TGit-Tech/Tode-IO/README.md

-----------------------------------------------------------------------------------
# Tode-IO (Part of the Tode-RC Project)
-----------------------------------------------------------------------------------
Various Input/Output (IO) accessibility hardware for a Tode-RC.

Visit https://github.com/TGit-Tech/Tode-RC

-----------------------------------------------------------------------------------
# Models
-----------------------------------------------------------------------------------
- Tode-ACCESSORY
	- Mounting Plates for 8.7x6.7x4.3 Project Boxes
	- Pole Mount Antenna Bracket

- Tode-BIOPH (Back-IO Pin Header)\
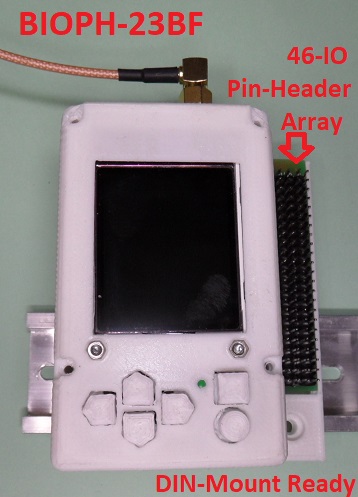
[picture p1: pics/BIOPH-23BF.jpg]


- Tode-IOSTB (IO Screw Terminal Block)\
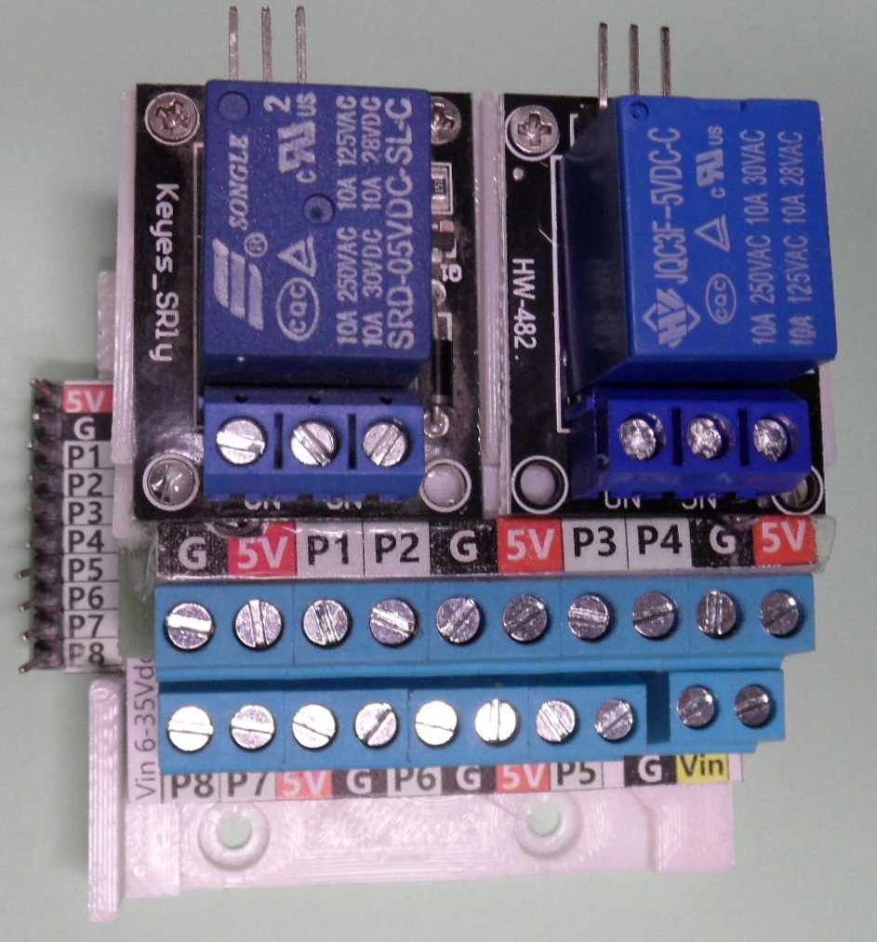
[picture p2: pics/IOSTB.24B7.jpg]


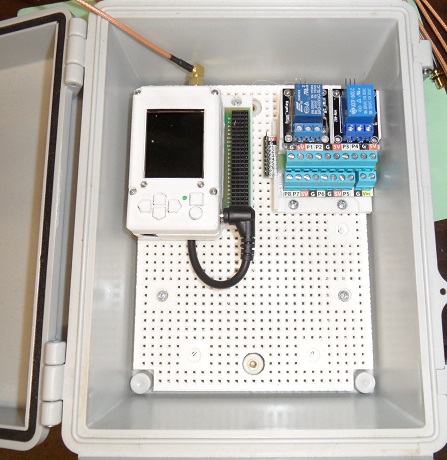
[picture p3: pics/BIOPHandIOSTB.jpg]
