TGit-Tech/Tode-IO/Tode-IOSTB/docs/Tode-IOSTB.24B7 Stickers.pdf

G | 5V | P1 | P2 | G | 5V | P3 | P4 | G | 5V
G | 5V | P1 | P2 | G | 5V | P3 | P4 | G | 5V
G | 5V | P1 | P2 | G | 5V | P3 | P4 | G | 5V
G | 5V | P1 | P2 | G | 5V | P3 | P4 | G | 5V
G | 5V | P1 | P2 | G | 5V | P3 | P4 | G | 5V
G | 5V | P1 | P2 | G | 5V | P3 | P4 | G | 5V
G | 5V | P1 | P2 | G | 5V | P3 | P4 | G | 5V
G | 5V | P1 | P2 | G | 5V | P3 | P4 | G | 5V
G | 5V | P1 | P2 | G | 5V | P3 | P4 | G | 5V
G | 5V | P1 | P2 | G | 5V | P3 | P4 | G | 5V
G | 5V | P1 | P2 | G | 5V | P3 | P4 | G | 5V
G | 5V | P1 | P2 | G | 5V | P3 | P4 | G | 5V
G | 5V | P1 | P2 | G | 5V | P3 | P4 | G | 5V
G | 5V | P1 | P2 | G | 5V | P3 | P4 | G | 5V
G | 5V | P1 | P2 | G | 5V | P3 | P4 | G | 5V
G | 5V | P1 | P2 | G | 5V | P3 | P4 | G | 5V
G | 5V | P1 | P2 | G | 5V | P3 | P4 | G | 5V
G | 5V | P1 | P2 | G | 5V | P3 | P4 | G | 5V
G | 5V | P1 | P2 | G | 5V | P3 | P4 | G | 5V
G | 5V | P1 | P2 | G | 5V | P3 | P4 | G | 5V
P8 P7 5V | G | P6 | G | 5V P5 | G VIN

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
P8 P7 5V | G | P6 | G | 5V P5 | G | Vin

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
Vin 6-35Vdc

P8 P7 5V | G | P6 | G | 5V P5 | G VIN

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
P8 P7 5V | G | P6 | G | 5V P5 | G | Vin

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
Vin 6-35Vdc

P8 P7 5V | G | P6 | G | 5V P5 | G VIN

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
P8 P7 5V | G | P6 | G | 5V P5 | G | Vin

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
Vin 6-35Vdc

P8 P7 5V | G | P6 | G | 5V P5 | G VIN

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
P8 P7 5V | G | P6 | G | 5V P5 | G | Vin

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
Vin 6-35Vdc

P8 P7 5V | G | P6 | G | 5V P5 | G VIN

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
P8 P7 5V | G | P6 | G | 5V P5 | G | Vin

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
Vin 6-35Vdc

P8 P7 5V | G | P6 | G | 5V P5 | G VIN

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
P8 P7 5V | G | P6 | G | 5V P5 | G | Vin

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
Vin 6-35Vdc

P8 P7 5V | G | P6 | G | 5V P5 | G VIN

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
P8 P7 5V | G | P6 | G | 5V P5 | G | Vin

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
Vin 6-35Vdc

P8 P7 5V | G | P6 | G | 5V P5 | G VIN

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
P8 P7 5V | G | P6 | G | 5V P5 | G | Vin

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
Vin 6-35Vdc
