TGit-Tech/Tode-IO/pics/IOSTB-Bottom+TopPCB-Layout.jpg

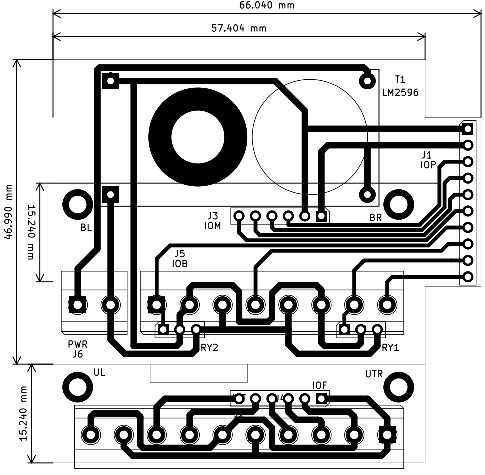
pics/IOSTB-Bottom+TopPCB-Layout.jpg
