TGit-Tech/Tode-IO/pics/IOSTB-BottomPCB-Schematic.jpg

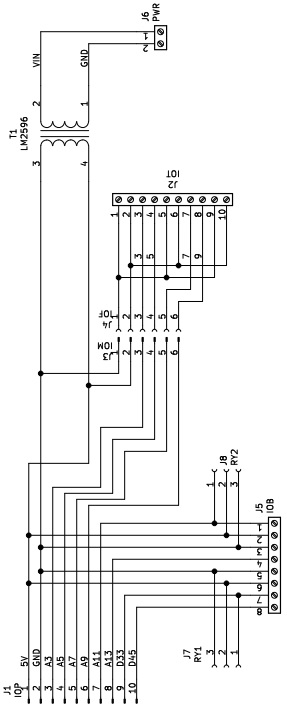
pics/IOSTB-BottomPCB-Schematic.jpg
