TGit-Tech/Tode-IO/pics/Joinfworld 6x6x4 Commercial Box.jpg

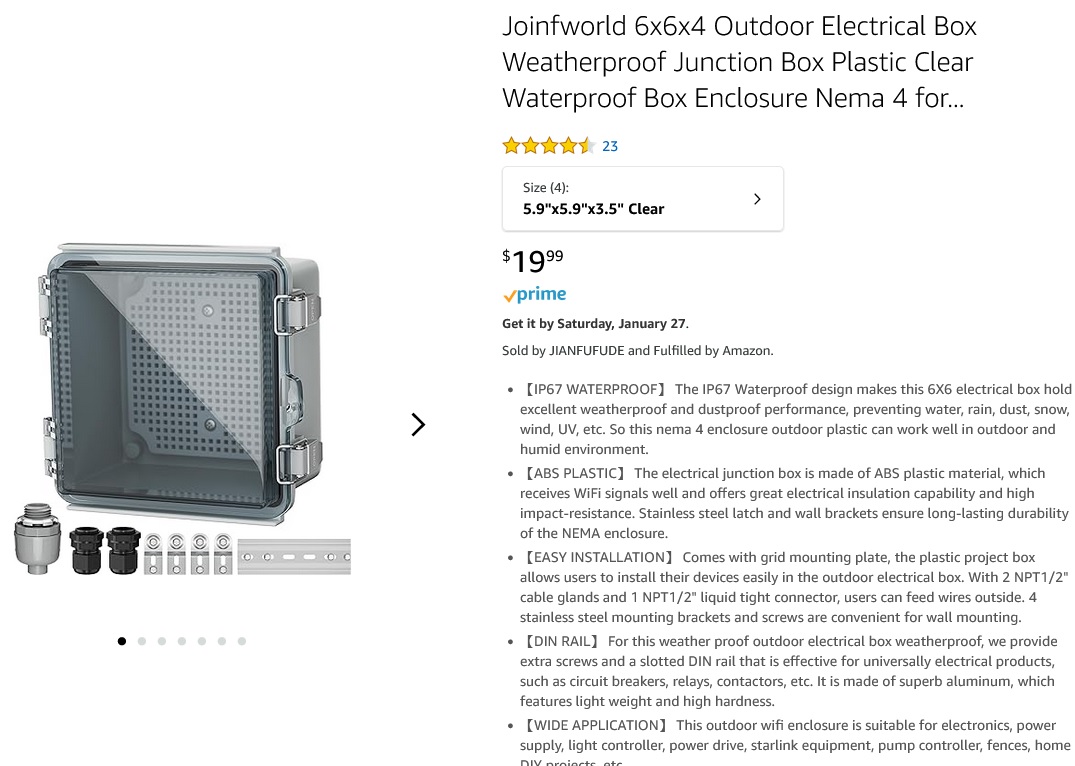
pics/Joinfworld 6x6x4 Commercial Box.jpg
