TGit-Tech/Tode-IO/Tode-ACCESSORY/pics/PoleMountAntennaBracket.png

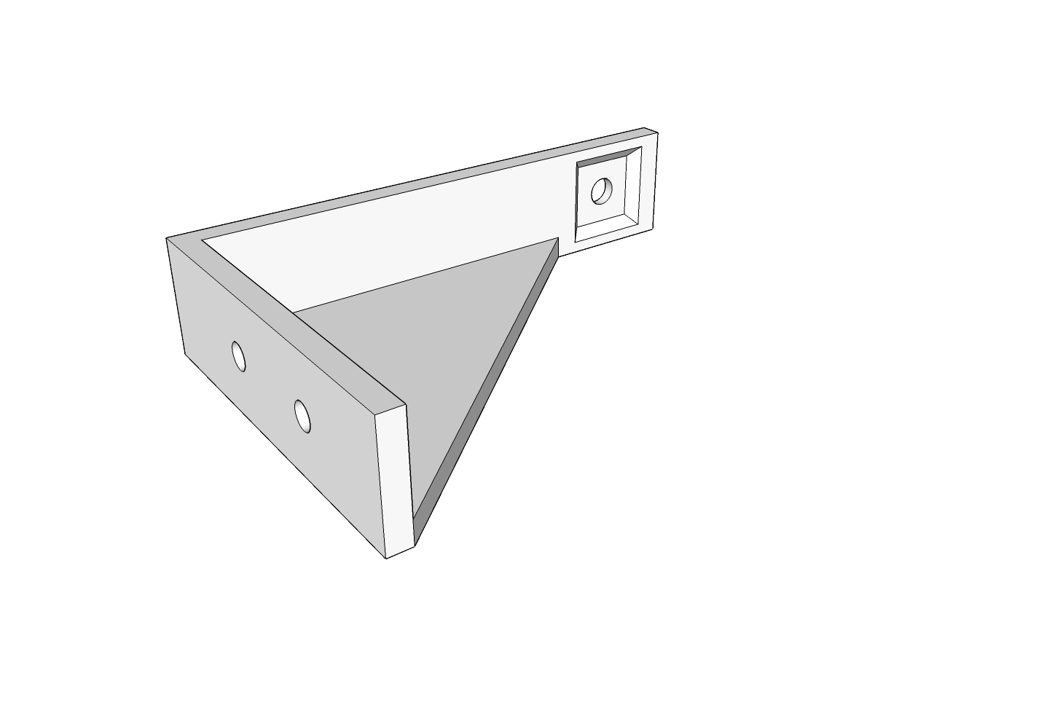
Tode-ACCESSORY/pics/PoleMountAntennaBracket.png
