TGit-Tech/Tode-IO/Tode-ACCESSORY/pics/SAM_7703.JPG

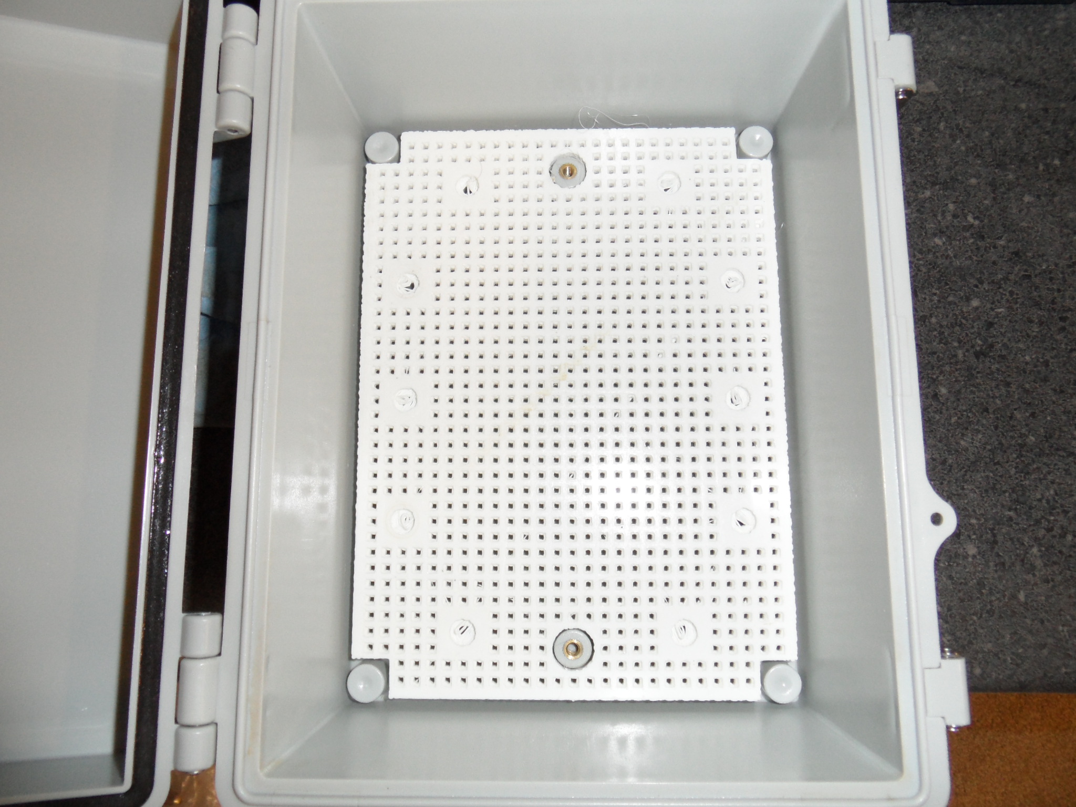
Tode-ACCESSORY/pics/SAM_7703.JPG
