TGit-Tech/Tode-IO/Tode-ACCESSORY/pics/SIOST-Zulkit974-6ScrewGrid.png

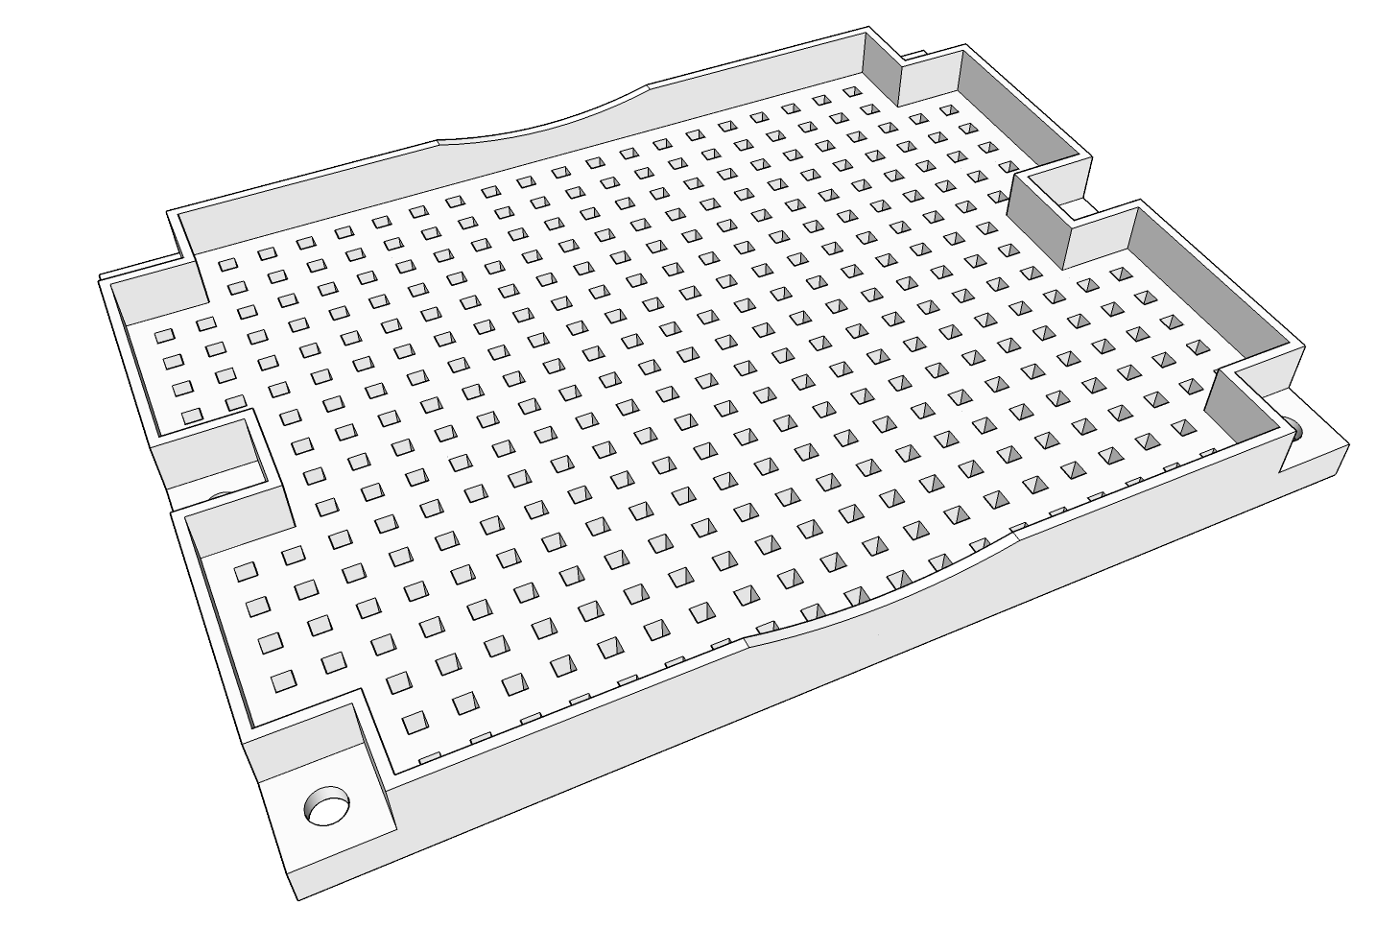
Tode-ACCESSORY/pics/SIOST-Zulkit974-6ScrewGrid.png
