TGit-Tech/Tode-IO/Tode-BIOPH/kicad/IO-ACCESS/Schematic.jpg

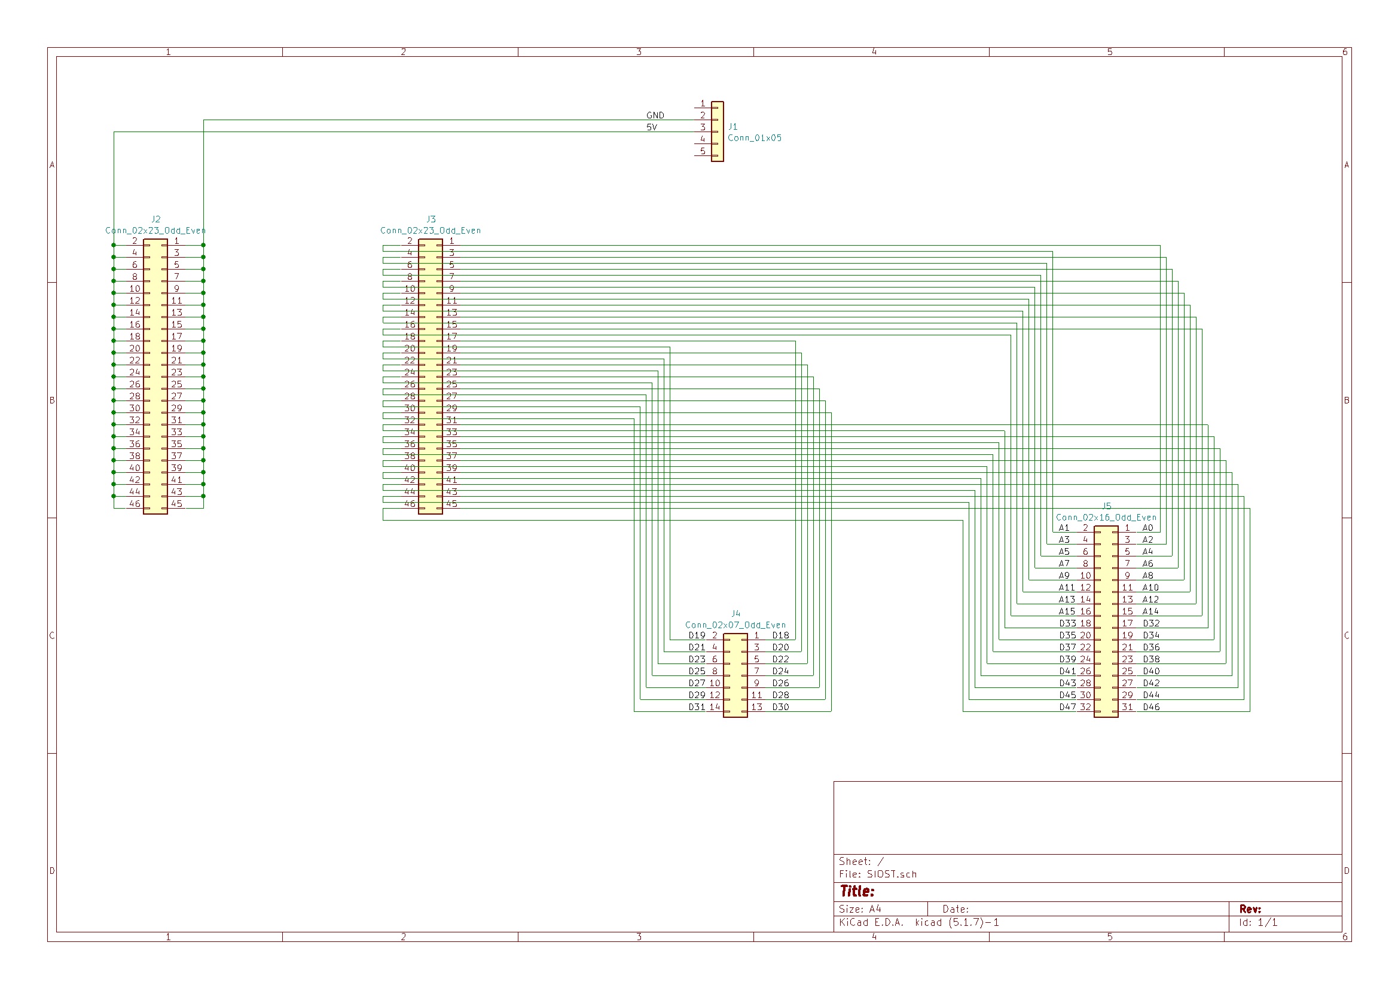
Tode-BIOPH/kicad/IO-ACCESS/Schematic.jpg
