TGit-Tech/Tode-IO/Tode-IOSTB/kicad/SIOST-BOTTOM/Bottom-Layout.jpg

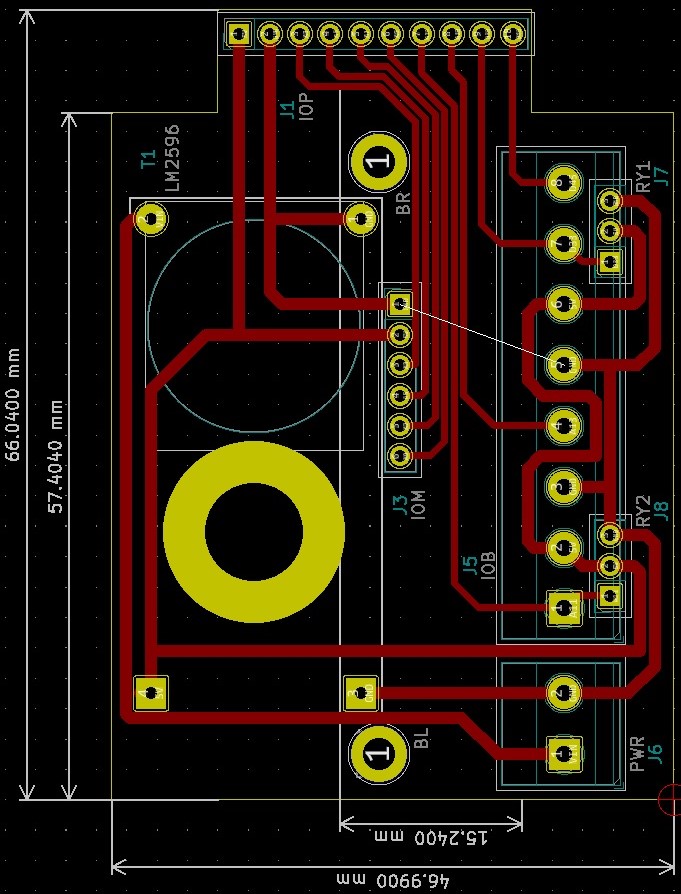
Tode-IOSTB/kicad/SIOST-BOTTOM/Bottom-Layout.jpg
