TGit-Tech/Tode-IO/Tode-IOSTB/kicad/SIOST-BOTTOM/Layout.jpg

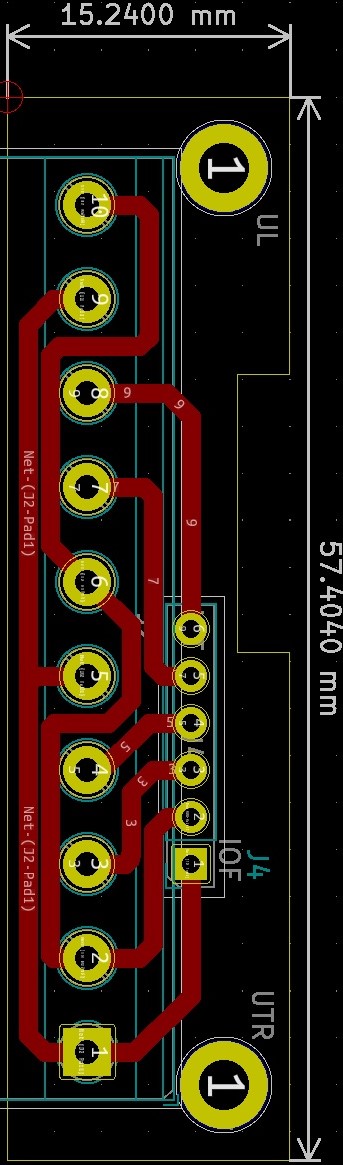
Tode-IOSTB/kicad/SIOST-BOTTOM/Layout.jpg
