TGit-Tech/Tode-IO/Tode-IOSTB/kicad/SIOST-BOTTOM/Schematic.jpg

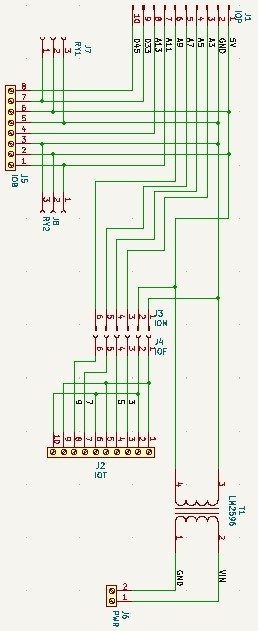
Tode-IOSTB/kicad/SIOST-BOTTOM/Schematic.jpg
