TGit-Tech/Tode-IO/pics/Zulkit-8.7x6.7x4.3-AmazonOrderPage.jpg

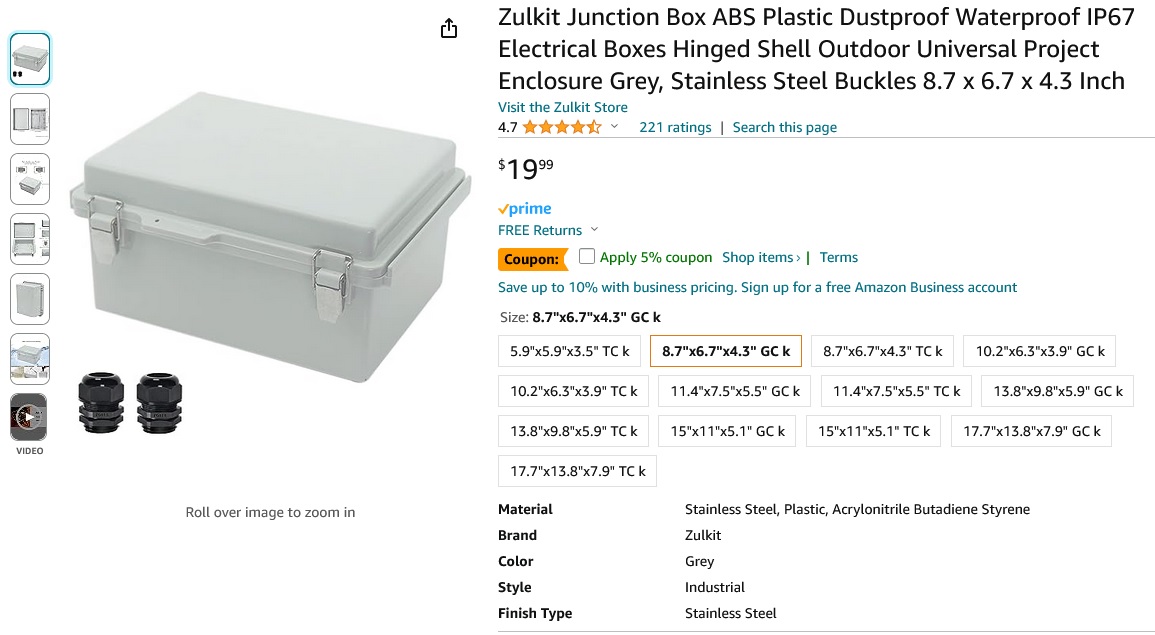
pics/Zulkit-8.7x6.7x4.3-AmazonOrderPage.jpg
