TGit-Tech/Tode-IO/Tode-ACCESSORY/PoleMountAntennaBracket.stl

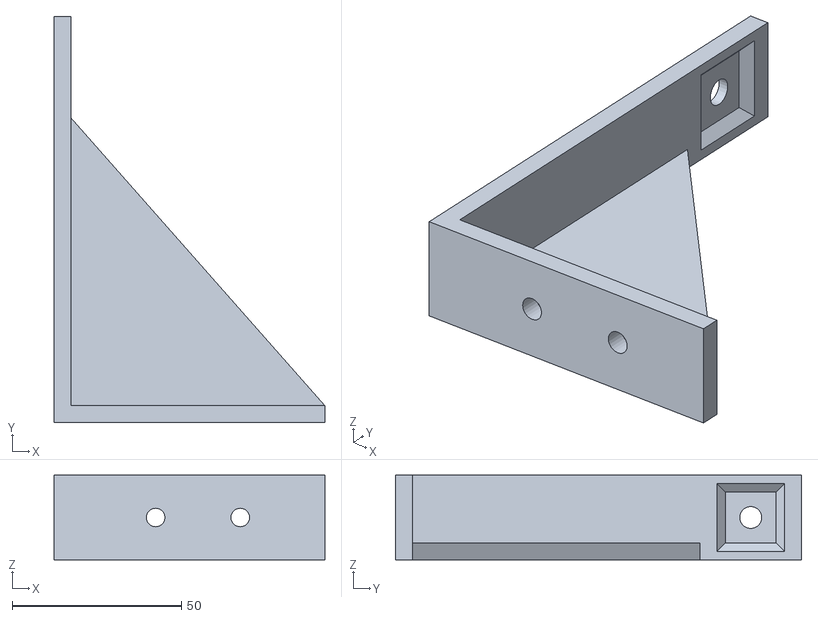
[picture p26: CAD file, 2024-01-26]
Tode-ACCESSORY/PoleMountAntennaBracket.stl
80.0 x 120.0 x 25.0
