TGit-Tech/Tode-IO/Tode-BIOPH/3DPrints/BIOPH.BackSide.249M.stl

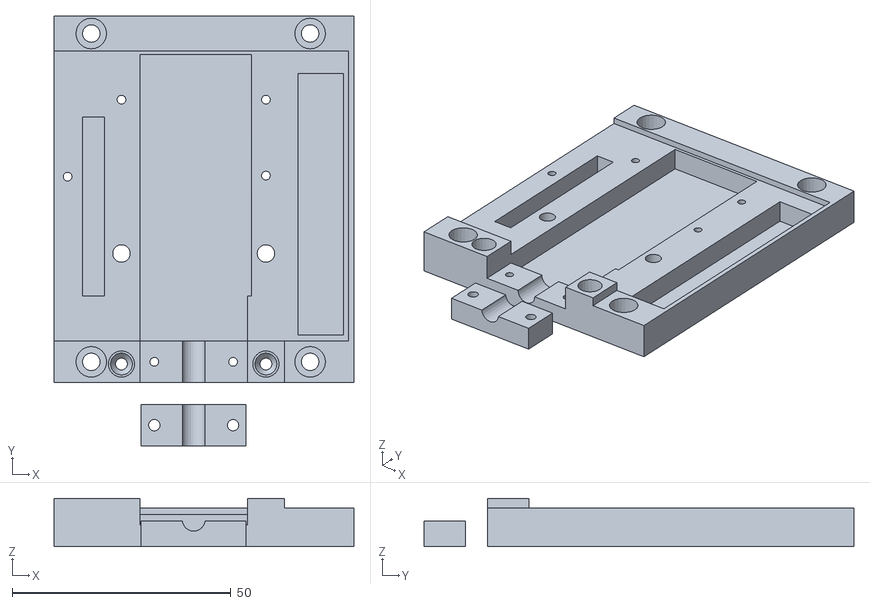
[picture p27: CAD file, 2024-12-30]
Tode-BIOPH/3DPrints/BIOPH.BackSide.249M.stl
68.5 x 98.2 x 11.1
