TGit-Tech/Tode-IO/Tode-IOSTB/3DPrints/IOSTB-Base.24B7.stl

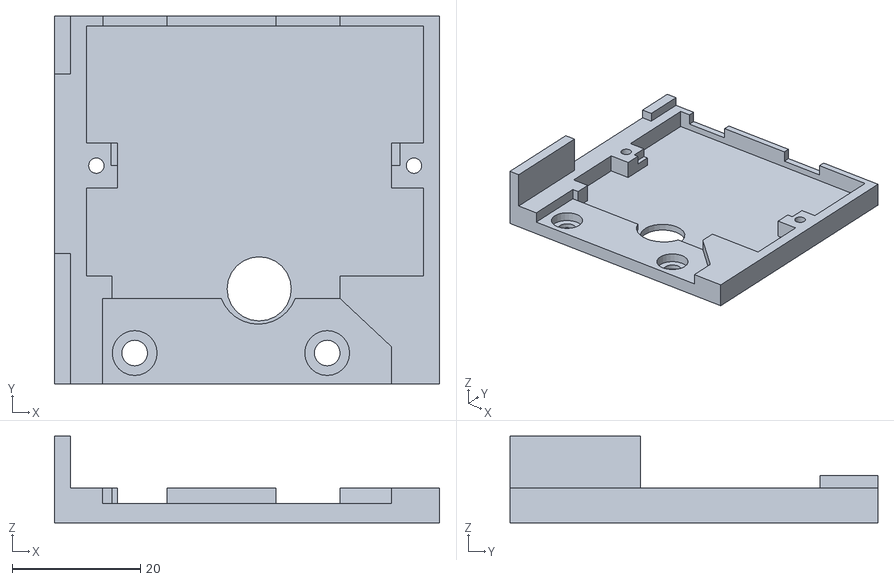
[picture p28: CAD file, 2024-12-30]
Tode-IOSTB/3DPrints/IOSTB-Base.24B7.stl
60.0 x 57.3 x 13.5
