TGit-Tech/Tode-IO/Tode-BIOPH/3DPrints/BIOPH.FrontSide.249Q.stl

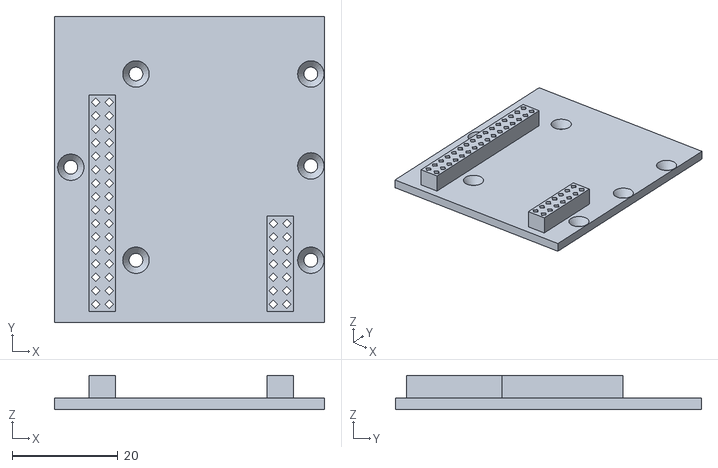
[picture p29: CAD file, 2024-12-30]
Tode-BIOPH/3DPrints/BIOPH.FrontSide.249Q.stl
51.0 x 57.8 x 6.50
