TGit-Tech/Tode-IO/Tode-IOSTB/3DPrints/IOSTB-Relays.24B7.stl

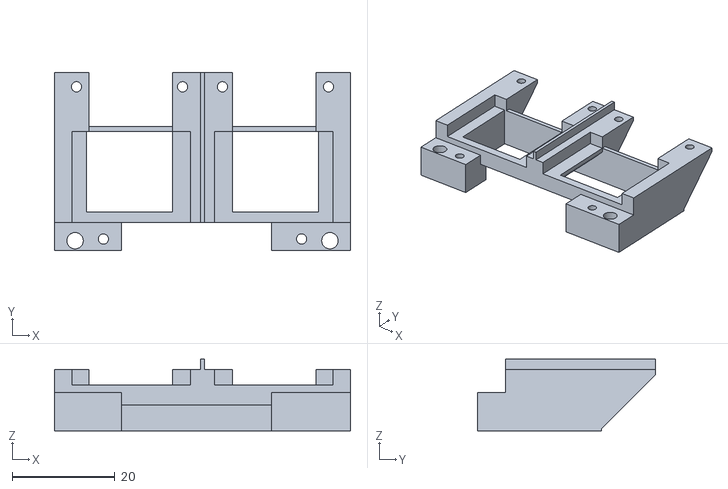
[picture p30: CAD file, 2024-12-30]
Tode-IOSTB/3DPrints/IOSTB-Relays.24B7.stl
57.5 x 34.6 x 13.9
