TGit-Tech/Tode-IO/Tode-IOSTB/3DPrints/IOSTB-Lift.24B7.stl

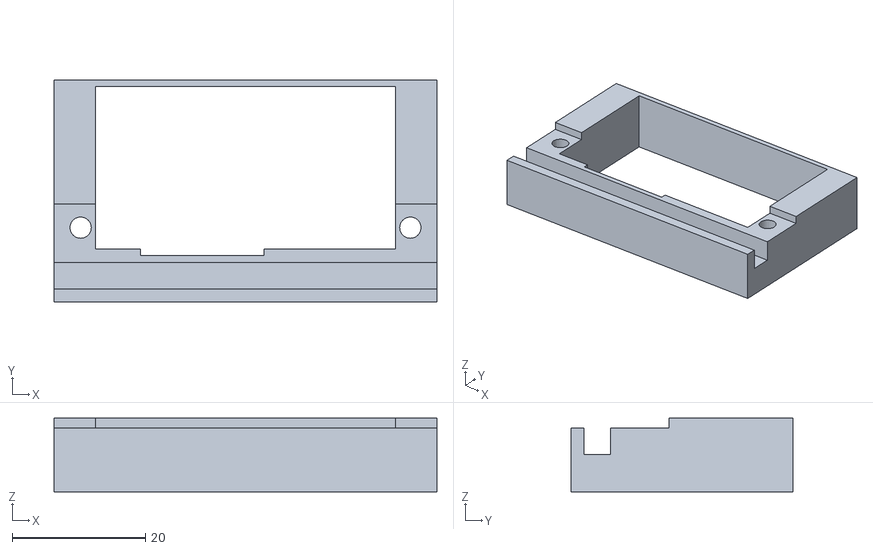
[picture p31: CAD file, 2024-12-30]
Tode-IOSTB/3DPrints/IOSTB-Lift.24B7.stl
57.5 x 33.4 x 11.1
