TGit-Tech/Tode-IO/Tode-IOSTB/3DPrints/IOSTB-Label.24B7.stl

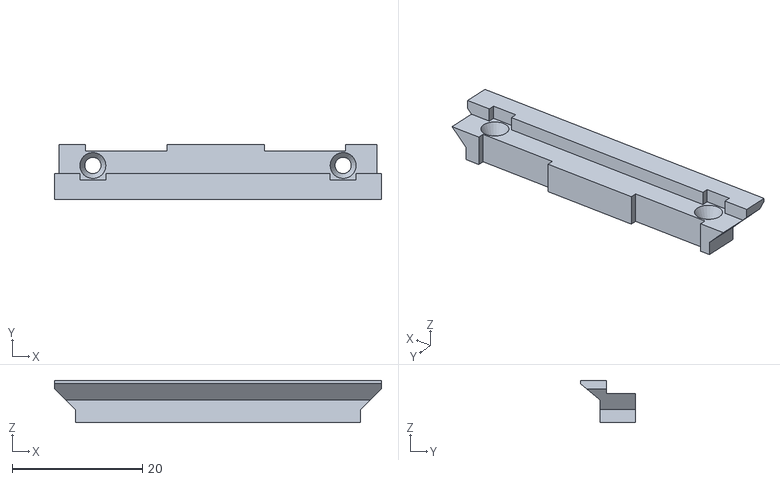
[picture p32: CAD file, 2024-12-30]
Tode-IOSTB/3DPrints/IOSTB-Label.24B7.stl
50.3 x 8.50 x 6.50
