TGit-Tech/Tode-IO/(list of files, cad)

Other CAD files:
Tode-ACCESSORY/skp/MountingPlate-Zulkit974inBox-5.08mmPitch-Unexploded.skp
Tode-ACCESSORY/skp/PoleMountAntennaBracket.skp
Tode-ACCESSORY/skp/SIOST-DeskStand.skp
Tode-ACCESSORY/skp/Tode-Relay-Mount.skp
Tode-BIOPH/3DPrints/skp/BIOPH.BackSide.249M.skp
Tode-BIOPH/3DPrints/skp/BIOPH.FrontSide.249Q.skp
Tode-IOSTB/3DPrints/skp/IOSTB-Assembly.24B7.skp
Tode-IOSTB/3DPrints/skp/IOSTB-Base.24B7.skp
Tode-IOSTB/3DPrints/skp/IOSTB-Label.24B7.skp
Tode-IOSTB/3DPrints/skp/IOSTB-Lift.24B7.skp
Tode-IOSTB/3DPrints/skp/IOSTB-Relays.24B7.skp
