TGit-Tech/Tode-IO/Tode-IOSTB/3DPrints/IOSTB-Assembly.jpg

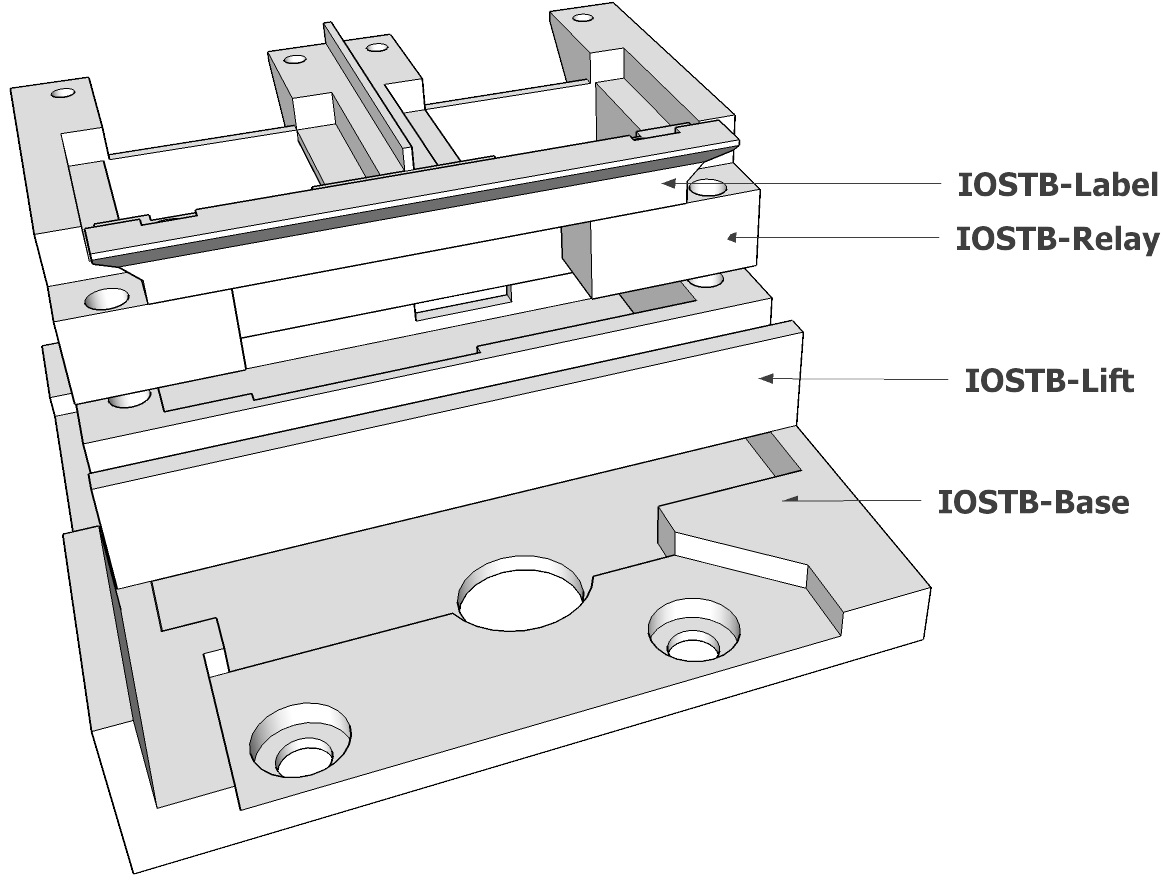
Tode-IOSTB/3DPrints/IOSTB-Assembly.jpg
