TGit-Tech/Tode-IO/Tode-BIOPH/kicad/IO-ACCESS/Layout.pdf

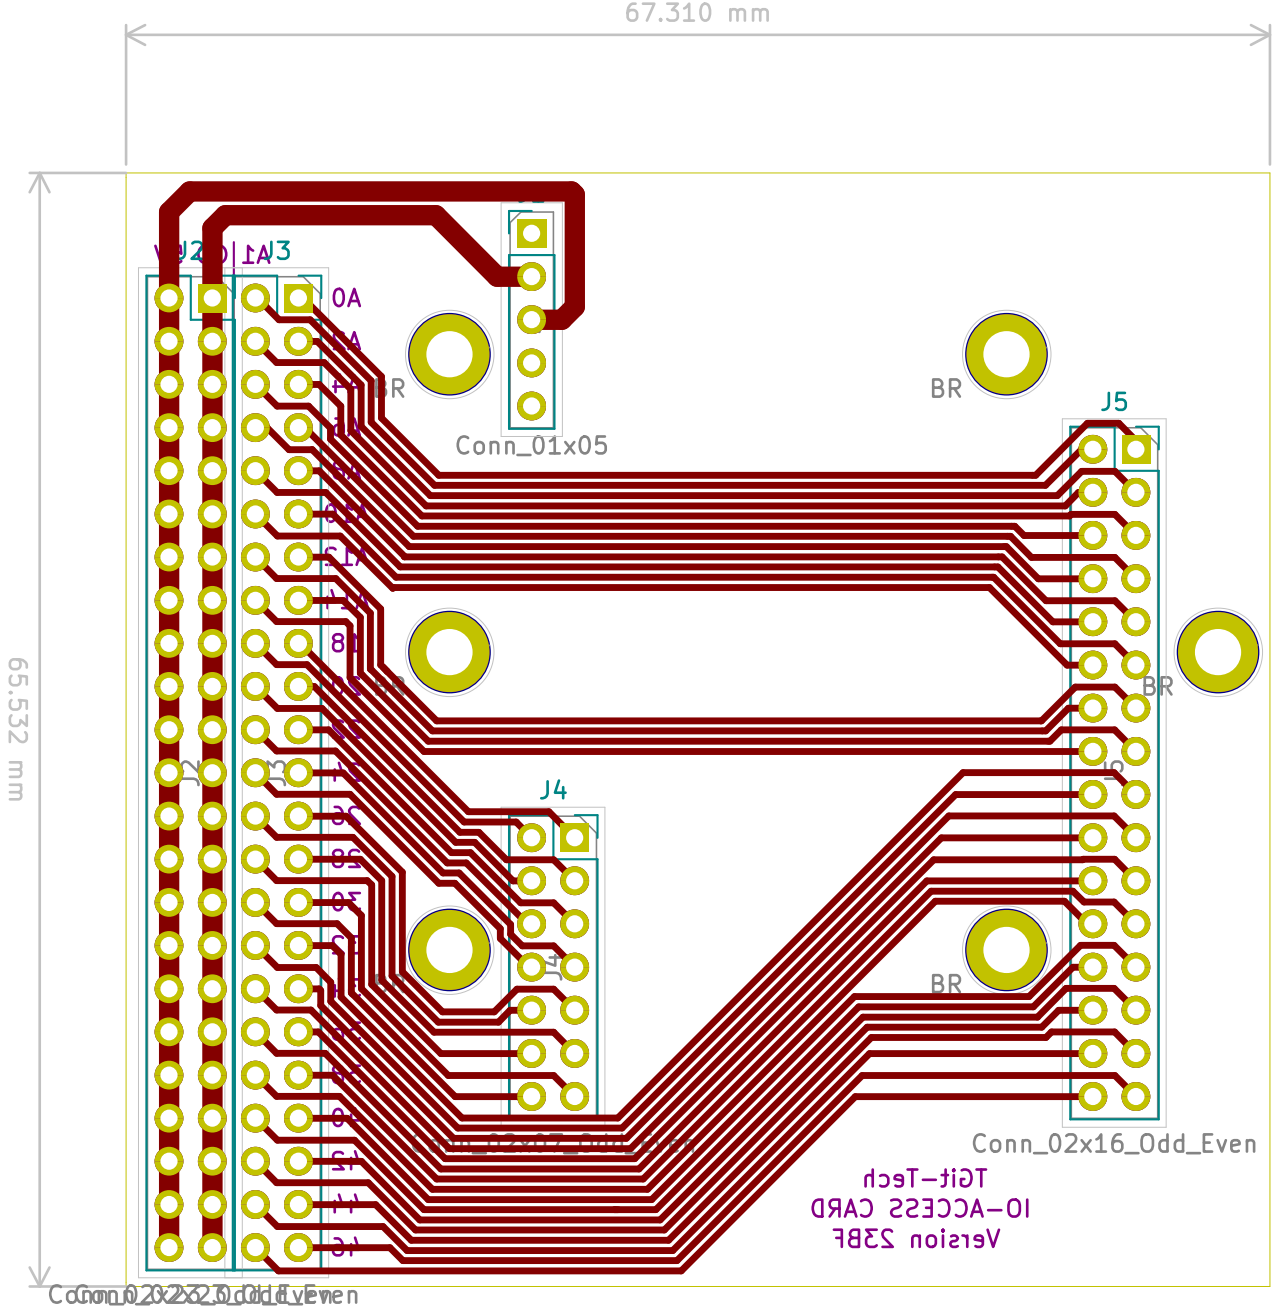
[picture p34: page 1]
