TGit-Tech/Tode-IO/(commit log)

2021-11-07 Initial
    Initial
    [SIOST-Assembly.skp, SIOST-Base.skp, SIOST-Base.stl, SIOST-CableEntry.skp, SIOST-CableEntry.stl, SIOST-CablePlug.skp, SIOST-CablePlug.stl, SIOST-Cover.skp]
2021-11-27 Update
    Updated Models Doc Updated
    [SIOST-Assembly.skp, SIOST-Base.skp, SIOST-Base.stl, SIOST-CableEntry.stl, SIOST-CablePlug.stl, SIOST-Cover.skp, SIOST-Cover.stl, SIOST-KBCover.skp]
2021-12-05 New KB Cover
    Lifted KB Cover Design
    [SIOST-Assembly.skp, SIOST-Base.skp, SIOST-Base.stl, SIOST-CableEntry.skp, SIOST-CableEntry.stl, SIOST-CablePlug.skp, SIOST-CablePlug.stl, SIOST-Cover.stl]
2022-01-07 Doc Change & Pole Hanger
    Added Pole Hanger Model & Doc Recreate
    [SIOST-OptPoleHanger.skp, SIOST-OptPoleHanger.stl]
2022-01-26 Base & Cover loosened, PCB-top & bottom separated
    [SIOST-Assembly.skp, SIOST-Base.skp, SIOST-Base.stl, SIOST-Cover.skp, SIOST-Cover.stl, SIOST-KBCover.skp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]
2022-01-26 Fix
    Fix
    [4W-TrailerConnector.kicad_pcb, 4W-TrailerConnector.sch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]
2024-01-26 Multi Tode-IO
    [4W-TrailerConnector.kicad_pcb, 4W-TrailerConnector.kicad_sch, 4W-TrailerConnector.sch, BIOPH-TodeSocket-Back.skp, BIOPH-TodeSocket-Front.skp, BIOPH-TodeSocket-Front.stl, PoleMountAntennaBracket.skp, PoleMountAntennaBracket.stl]
2024-02-21 BIOPH and SIOST
    [BIOPH-BackSide.skp, BIOPH-BackSide.stl, BIOPH-FrontSide.skp, BIOPH-FrontSide.stl, BIOPH-TodeSocket-Back.skp, BIOPH-TodeSocket-Front.skp, BIOPH-TodeSocket-Front.stl, SIOST-1W.skp]
2024-12-30 Cleaned up
    [2024-02-19 BIOPH-BackSide.skp, 2024-09-08 BIOPH-BackSide.skp, 2024-09-08 BIOPH-FrontSide.skp, 2024-09-08 UN-Scaled BIOPH-BackSide.skp, 2024-09-09 BIOPH-BackSide-CB-TopHoles.skp, 4W-TrailerConnector.kicad_pcb, 4W-TrailerConnector.kicad_sch, 4W-TrailerConnector.sch]
2024-12-30 clean up
    [2024-02-19 BIOPH-BackSide.skp, 2024-09-08 BIOPH-BackSide.skp, 2024-09-08 BIOPH-FrontSide.skp, 2024-09-08 UN-Scaled BIOPH-BackSide.skp, 2024-09-09 BIOPH-BackSide-CB-TopHoles.skp, BIOPH-FrontSide-UnScaled.skp, BIOPH-FrontSide.skp, BIOPH-Parts.ods]
